mitsalgh/portalParkirTKI/Controller PCB/check in/preview/PCB Atas.png

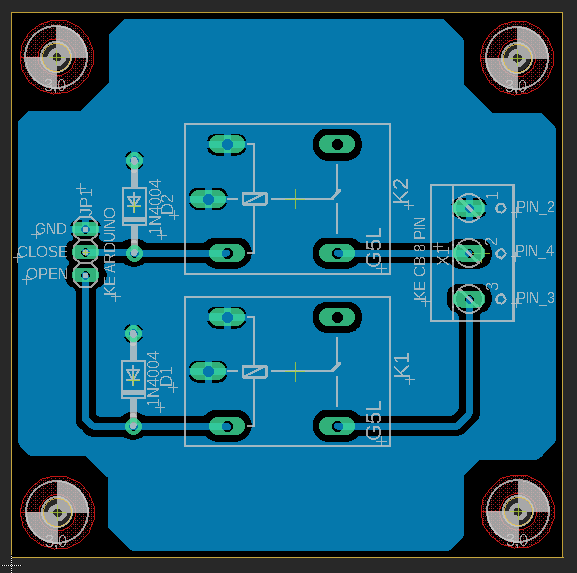
Controller PCB/check in/preview/PCB Atas.png
