mitsalgh/portalParkirTKI/Controller PCB/check in/preview/PCB Bawah.png

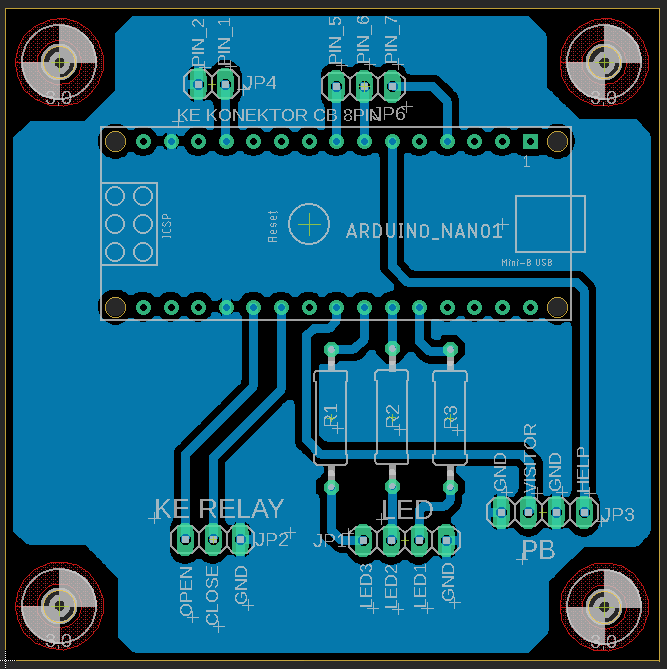
Controller PCB/check in/preview/PCB Bawah.png
