mitsalgh/portalParkirTKI/Controller PCB/check in/preview/Pemasangan PCB Atas dan Bawah.png

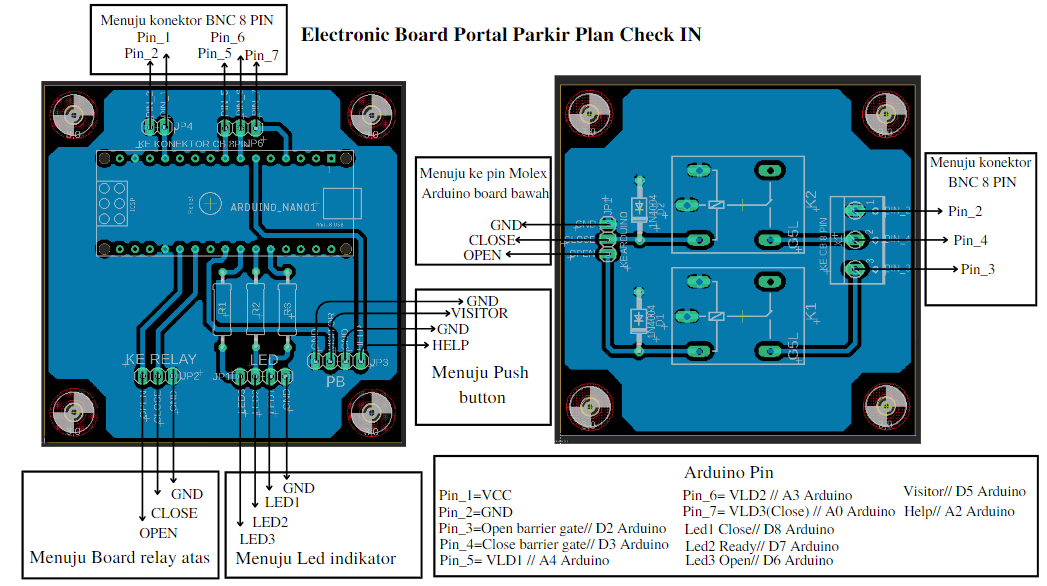
Controller PCB/check in/preview/Pemasangan PCB Atas dan Bawah.png
