mitsalgh/portalParkirTKI/Controller PCB/check in/preview/Skema Board Atas.png

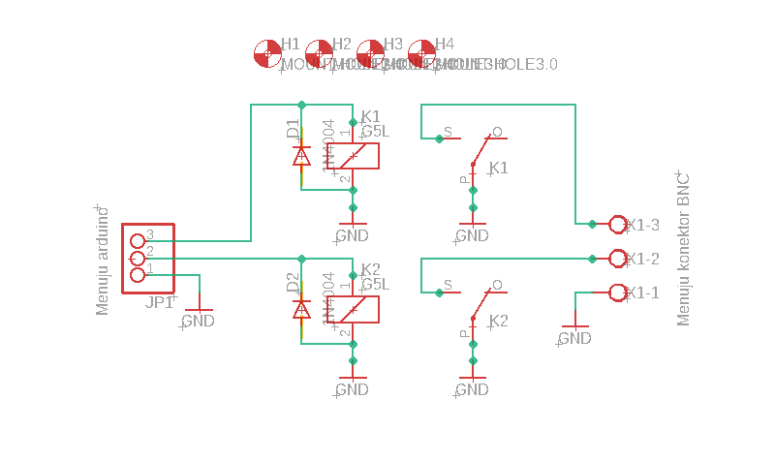
Controller PCB/check in/preview/Skema Board Atas.png
