mitsalgh/portalParkirTKI/Controller PCB/check in/preview/Skema Board Bawah.png

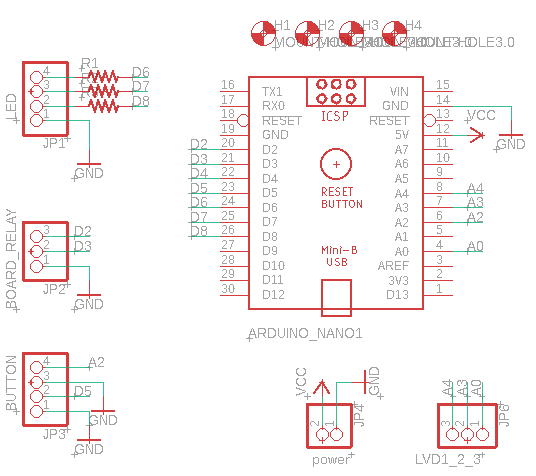
Controller PCB/check in/preview/Skema Board Bawah.png
