mitsalgh/portalParkirTKI/Controller PCB/check out/preview/PCB Bawah.png

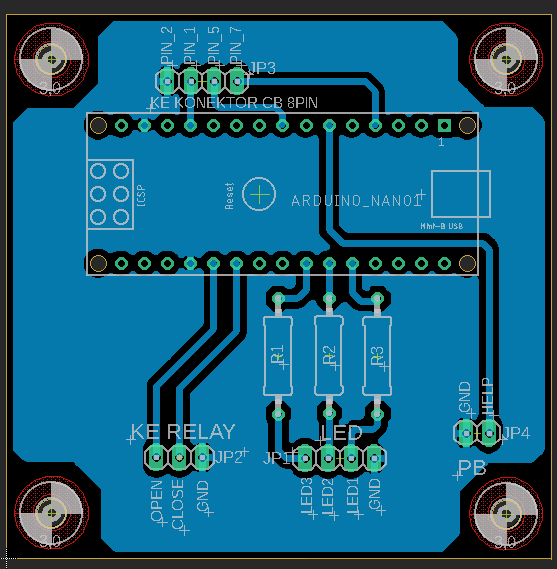
Controller PCB/check out/preview/PCB Bawah.png
