mitsalgh/portalParkirTKI/Controller PCB/check out/preview/Pemasangan PCB Atas dan Bawah.png

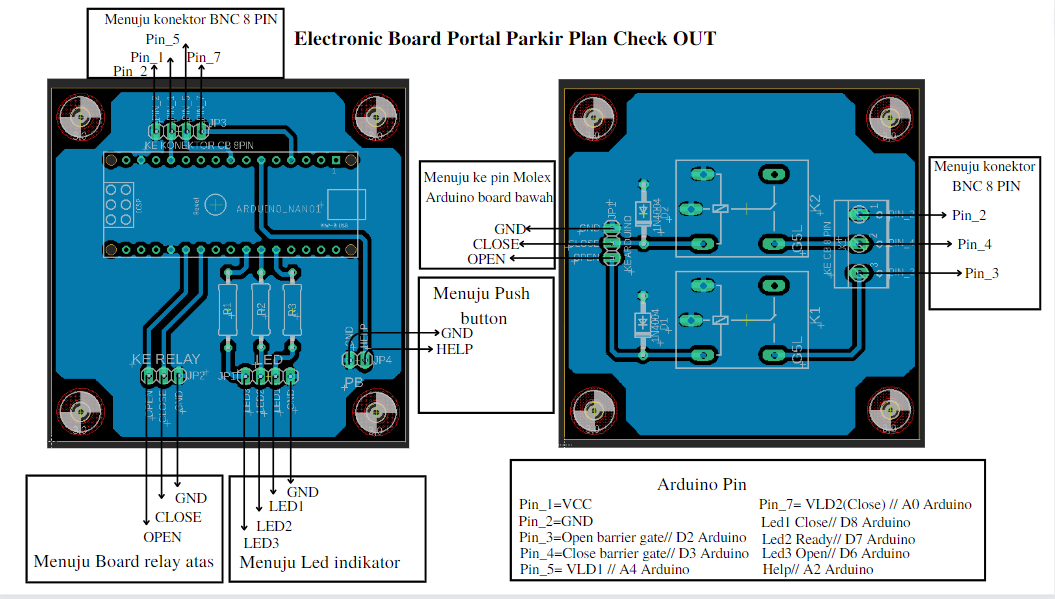
Controller PCB/check out/preview/Pemasangan PCB Atas dan Bawah.png
