mitsalgh/portalParkirTKI/Controller PCB/check out/preview/Skema Board Atas.png

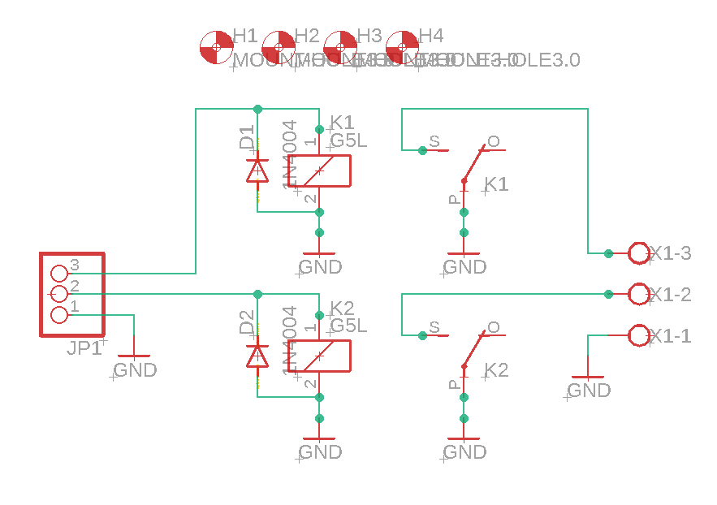
Controller PCB/check out/preview/Skema Board Atas.png
