mitsalgh/portalParkirTKI/Controller PCB/check out/preview/Skema Board Bawah.png

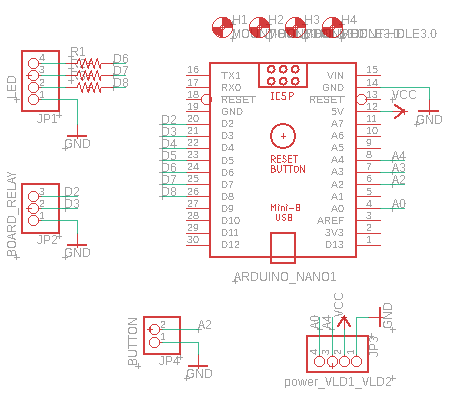
Controller PCB/check out/preview/Skema Board Bawah.png
