mitsalgh/portalParkirTKI/2D portal_parkir/Check IN/Acrylic/DFX/Acrylic E-Money.dxf

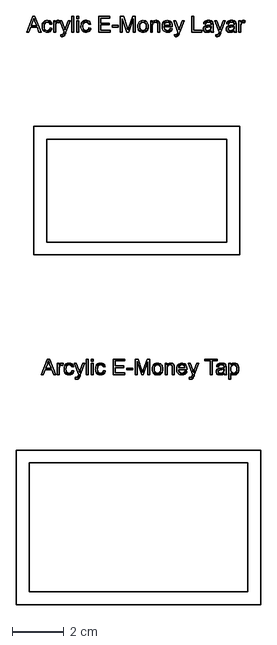
[picture p10: CAD file, 2023-12-26]
2D portal_parkir/Check IN/Acrylic/DFX/Acrylic E-Money.dxf
9.50 x 22.8 cm
