mitsalgh/portalParkirTKI/2D portal_parkir/Check IN/Plat/DFX/Box New Portal Parkir.dxf

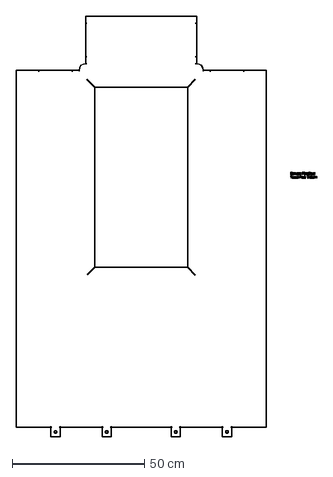
[picture p11: CAD file, 2023-12-26]
2D portal_parkir/Check IN/Plat/DFX/Box New Portal Parkir.dxf
113.7 x 158.8 cm
