mitsalgh/portalParkirTKI/2D portal_parkir/Check OUT/Acrylic/DFX/Acrylic NFC.dxf

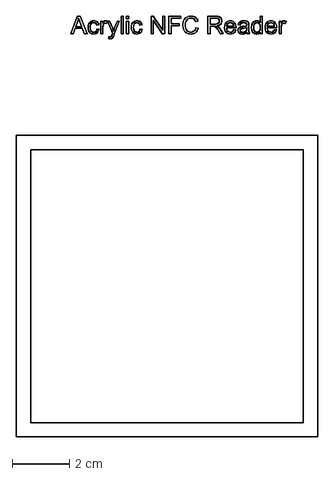
[picture p12: CAD file, 2023-12-26]
2D portal_parkir/Check OUT/Acrylic/DFX/Acrylic NFC.dxf
10.5 x 14.7 cm
