mitsalgh/portalParkirTKI/2D portal_parkir/Check OUT/Plat/DFX/Box Plat Belakang.dxf

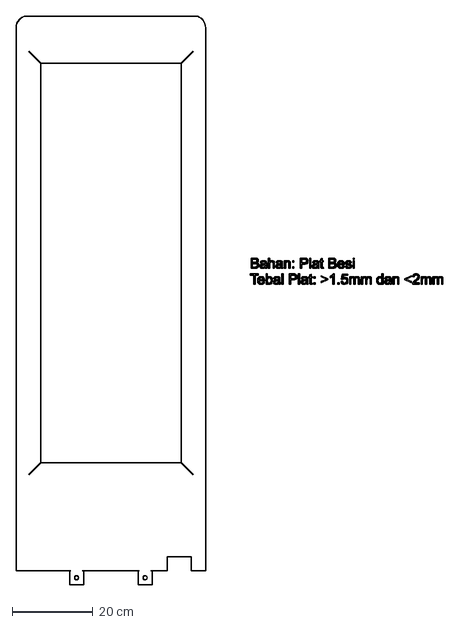
[picture p13: CAD file, 2023-12-26]
2D portal_parkir/Check OUT/Plat/DFX/Box Plat Belakang.dxf
105.9 x 141.0 cm
