mitsalgh/portalParkirTKI/2D portal_parkir/Check IN/Acrylic/DFX/Acrylic QR.dxf

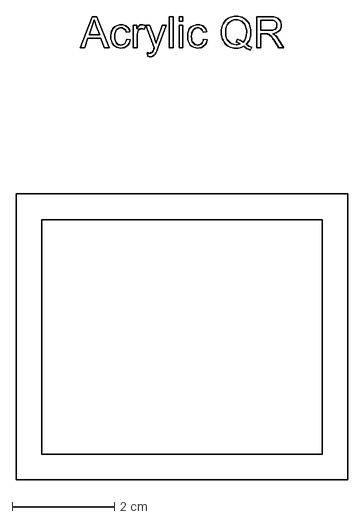
[picture p14: CAD file, 2023-12-26]
2D portal_parkir/Check IN/Acrylic/DFX/Acrylic QR.dxf
6.50 x 9.08 cm
