mitsalgh/portalParkirTKI/2D portal_parkir/Check IN/Plat/DFX/Bracket Printer.dxf

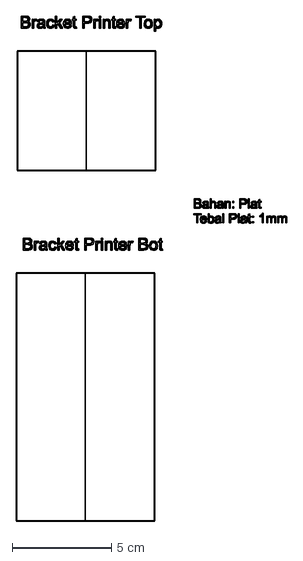
[picture p15: CAD file, 2023-12-26]
2D portal_parkir/Check IN/Plat/DFX/Bracket Printer.dxf
13.6 x 25.5 cm
