mitsalgh/portalParkirTKI/2D portal_parkir/Check OUT/Plat/DFX/Bracket NFC.dxf

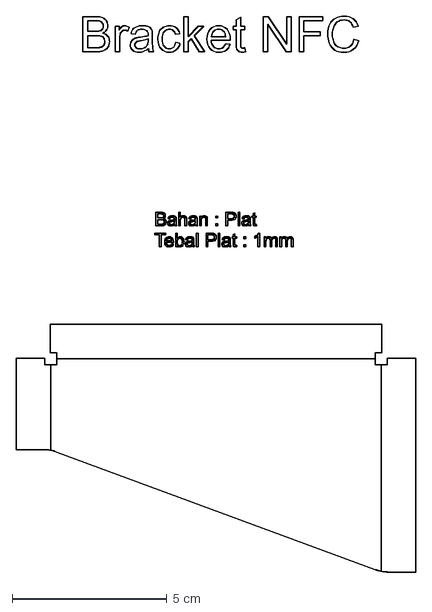
[picture p16: CAD file, 2023-12-26]
2D portal_parkir/Check OUT/Plat/DFX/Bracket NFC.dxf
12.9 x 18.0 cm
