mitsalgh/portalParkirTKI/2D portal_parkir/Check IN/Plat/DFX/Desain 2D Pintu Belakang.dxf

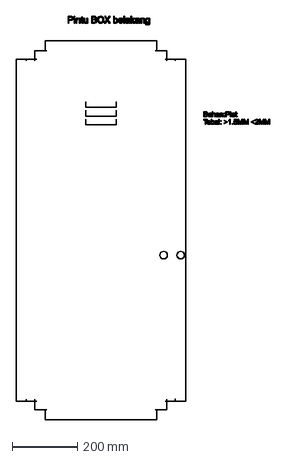
[picture p17: CAD file, 2023-12-26]
2D portal_parkir/Check IN/Plat/DFX/Desain 2D Pintu Belakang.dxf
776.1 x 1235.5 mm
