mitsalgh/portalParkirTKI/2D portal_parkir/Check OUT/Acrylic/DFX/Acrylic Monitor.dxf

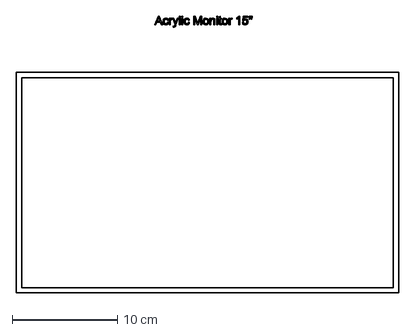
[picture p18: CAD file, 2023-12-26]
2D portal_parkir/Check OUT/Acrylic/DFX/Acrylic Monitor.dxf
36.4 x 26.4 cm
