mitsalgh/portalParkirTKI/2D portal_parkir/Check OUT/Plat/DFX/Desain 2D Pintu Check Out.dxf

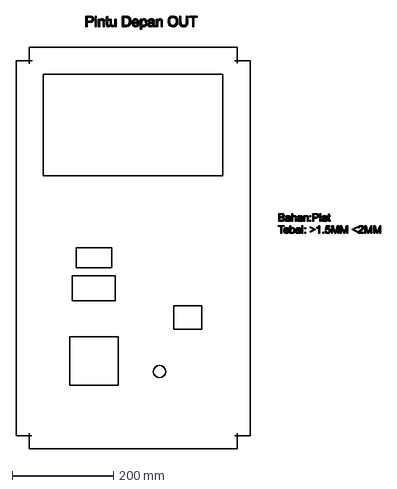
[picture p19: CAD file, 2023-12-26]
2D portal_parkir/Check OUT/Plat/DFX/Desain 2D Pintu Check Out.dxf
719.6 x 853.8 mm
