mitsalgh/portalParkirTKI/2D portal_parkir/Check IN/Plat/DFX/Bracket MCB.dxf

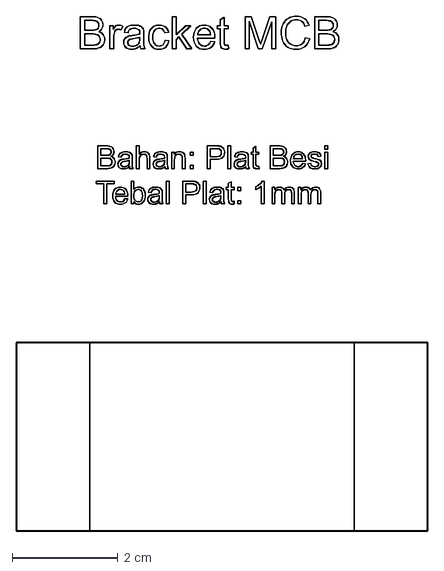
[picture p20: CAD file, 2023-12-26]
2D portal_parkir/Check IN/Plat/DFX/Bracket MCB.dxf
7.77 x 9.71 cm
