mitsalgh/portalParkirTKI/2D portal_parkir/Check IN/Plat/DFX/Bracket QR.dxf

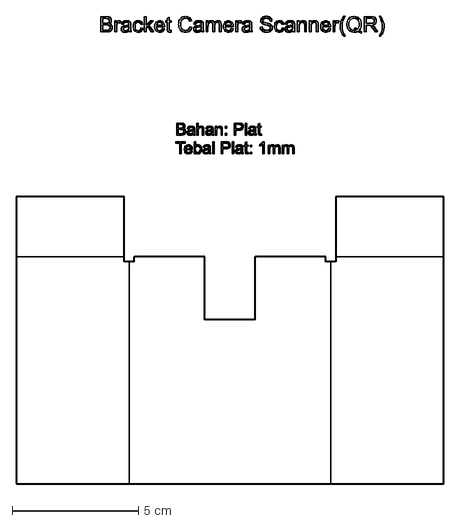
[picture p21: CAD file, 2023-12-26]
2D portal_parkir/Check IN/Plat/DFX/Bracket QR.dxf
17.0 x 18.5 cm
