mitsalgh/portalParkirTKI/2D portal_parkir/Check IN/Plat/DFX/Bracket E-Money.dxf

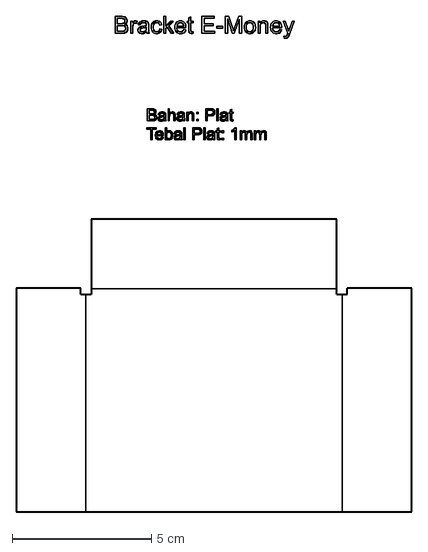
[picture p22: CAD file, 2023-12-26]
2D portal_parkir/Check IN/Plat/DFX/Bracket E-Money.dxf
14.2 x 17.8 cm
