mitsalgh/portalParkirTKI/2D portal_parkir/Check IN/Plat/DFX/Bracket STB.dxf

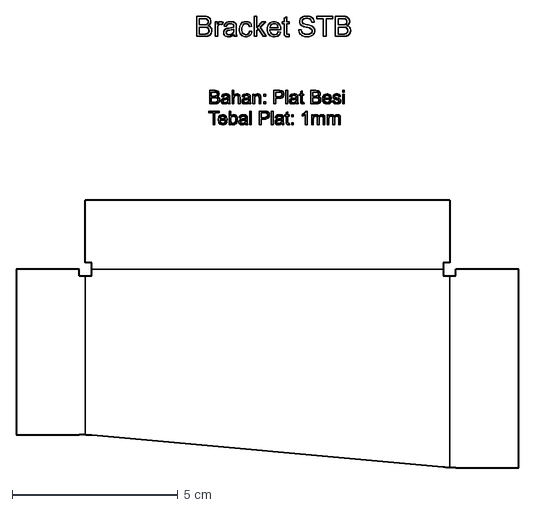
[picture p23: CAD file, 2023-12-26]
2D portal_parkir/Check IN/Plat/DFX/Bracket STB.dxf
15.2 x 13.6 cm
