mitsalgh/portalParkirTKI/2D portal_parkir/Check IN/Plat/DFX/Desain 2D Pintu Check In.dxf

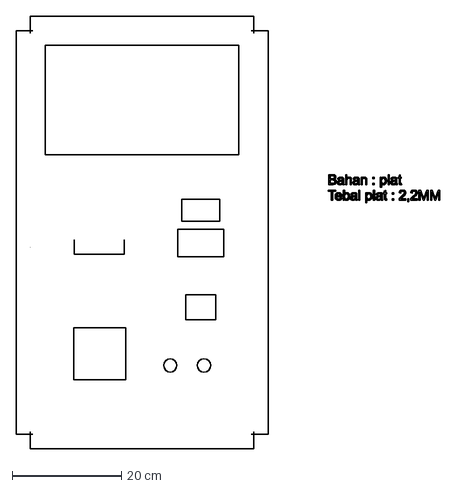
[picture p24: CAD file, 2023-12-26]
2D portal_parkir/Check IN/Plat/DFX/Desain 2D Pintu Check In.dxf
77.7 x 79.2 cm
