mitsalgh/portalParkirTKI/Controller PCB/check in/Board_Skematic/board Bawah/portal parkir bawah.brd

## EAGLE design Controller PCB/check in/Board_Skematic/board Bawah/portal parkir bawah.brd (2023-11-13)

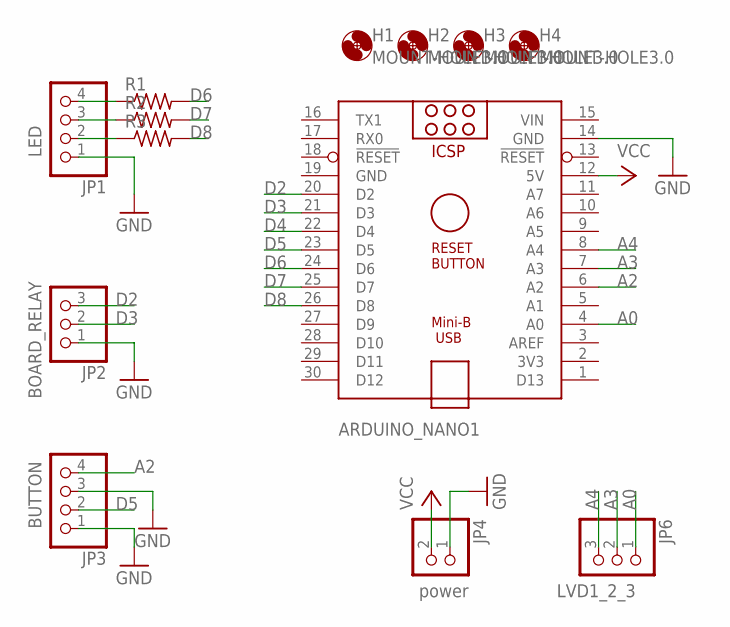
[picture p25: schematic portal parkir bawah.sch]

Parts:
ARDUINO_NANO1: ARDUINO_NANO
H1, H2, H3, H4: MOUNT-HOLE3.0; 3,0
JP1, JP3: PINHD-1X4; 1X04
JP2, JP6: PINHD-1X3; 1X03
JP4: PINHD-1X2; 1X02
R1, R2, R3: R-US_0309/12; 0309/12

Connections:
A0: ARDUINO_NANO1.4 (A0), JP6.1
A2: ARDUINO_NANO1.6 (A2), JP3.4
A3: ARDUINO_NANO1.7 (A3), JP6.2
A4: ARDUINO_NANO1.8 (A4), JP6.3
D2: ARDUINO_NANO1.20 (D2), JP2.3
D3: ARDUINO_NANO1.21 (D3), JP2.2
D4: ARDUINO_NANO1.22 (D4)
D5: ARDUINO_NANO1.23 (D5), JP3.2
D6: ARDUINO_NANO1.24 (D6), R1.2
D7: ARDUINO_NANO1.25 (D7), R2.2
D8: ARDUINO_NANO1.26 (D8), R3.2
GND: ARDUINO_NANO1.14 (GND), ARDUINO_NANO1.19 (GND), JP1.1, JP2.1, JP3.1, JP3.3, JP4.1
unnamed: JP1.2, R3.1
unnamed: JP1.3, R2.1
unnamed: JP1.4, R1.1
VCC: ARDUINO_NANO1.12 (5V), JP4.2
VIN: ARDUINO_NANO1.15 (VIN)

Notes on the sheet:
power
LVD1_2_3
BUTTON
BOARD_RELAY
LED

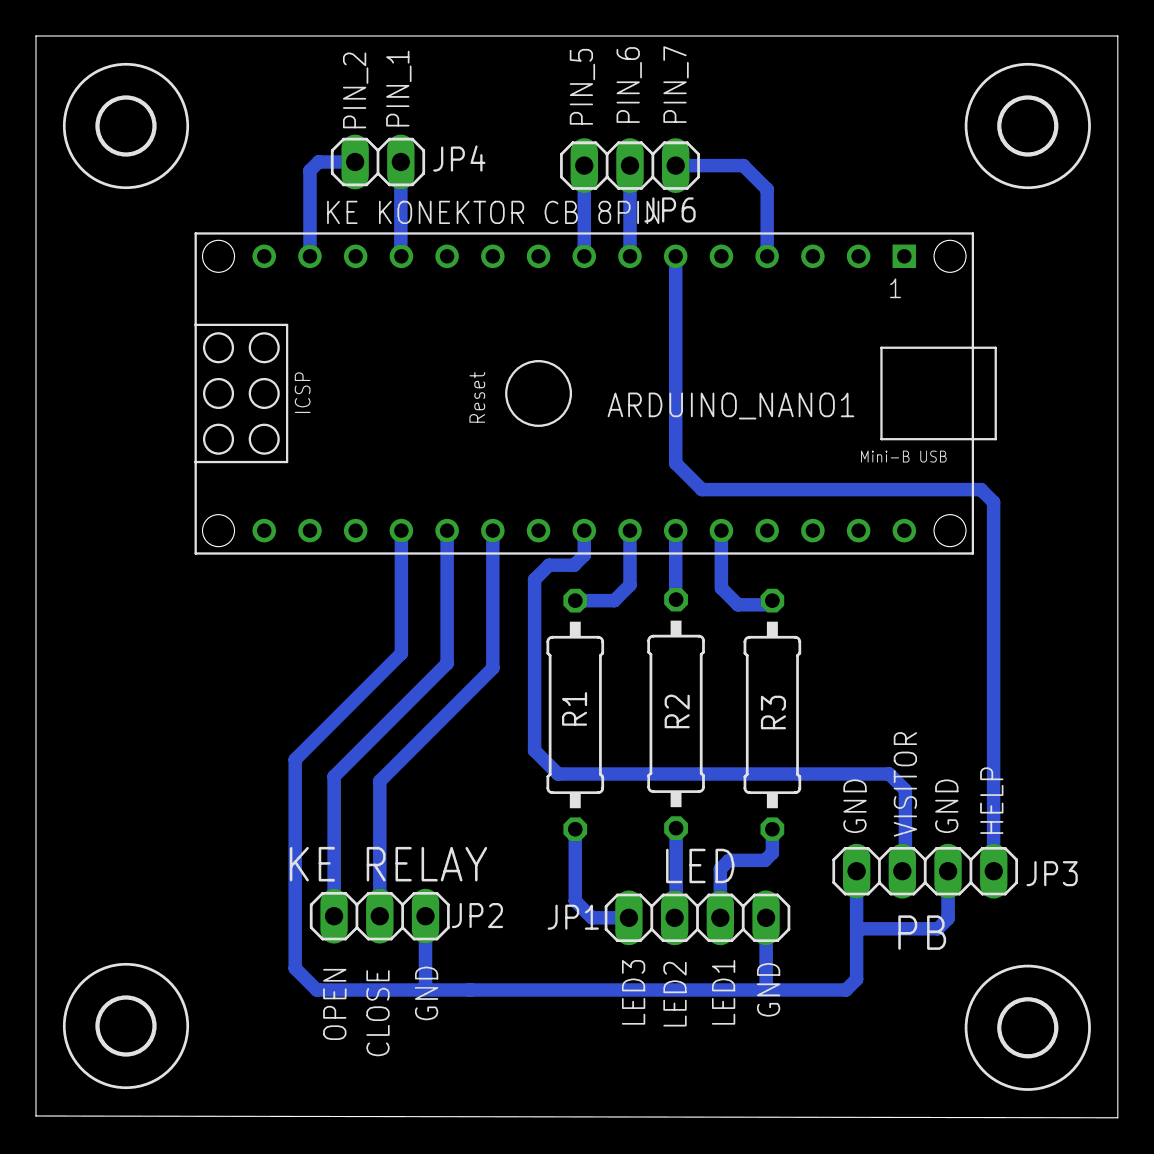
[picture p26: board portal parkir bawah.brd from above]

Board: 2 copper layers, 60.1 x 60.1 mm, 13 parts (0 on the bottom side), 15 nets.
