mitsalgh/portalParkirTKI/Controller PCB/check in/Board_Skematic/board Atas/portal parkir.brd

## EAGLE design Controller PCB/check in/Board_Skematic/board Atas/portal parkir.brd (2023-11-09)

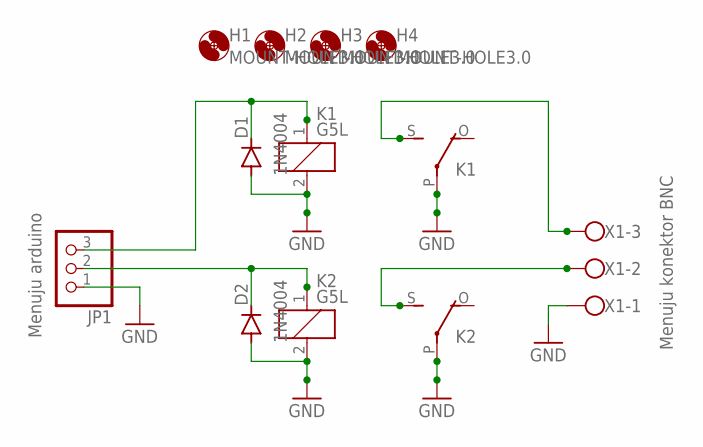
[picture p27: schematic portal parkir.sch]

Parts:
D1, D2: 1N4004; DO41-10
H1, H2, H3, H4: MOUNT-HOLE3.0; 3,0
JP1: PINHD-1X3; 1X03
K1, K2: G5L; G5LE
X1: W237-103

Connections:
GND: D1.A, D2.A, JP1.1, K1.2, K1.P, K2.2, K2.P, X1.1
unnamed: D1.C, JP1.3, K1.1
unnamed: D2.C, JP1.2, K2.1
unnamed: K2.S, X1.2
unnamed: K1.S, X1.3

Notes on the sheet:
Menuju arduino
Menuju konektor BNC

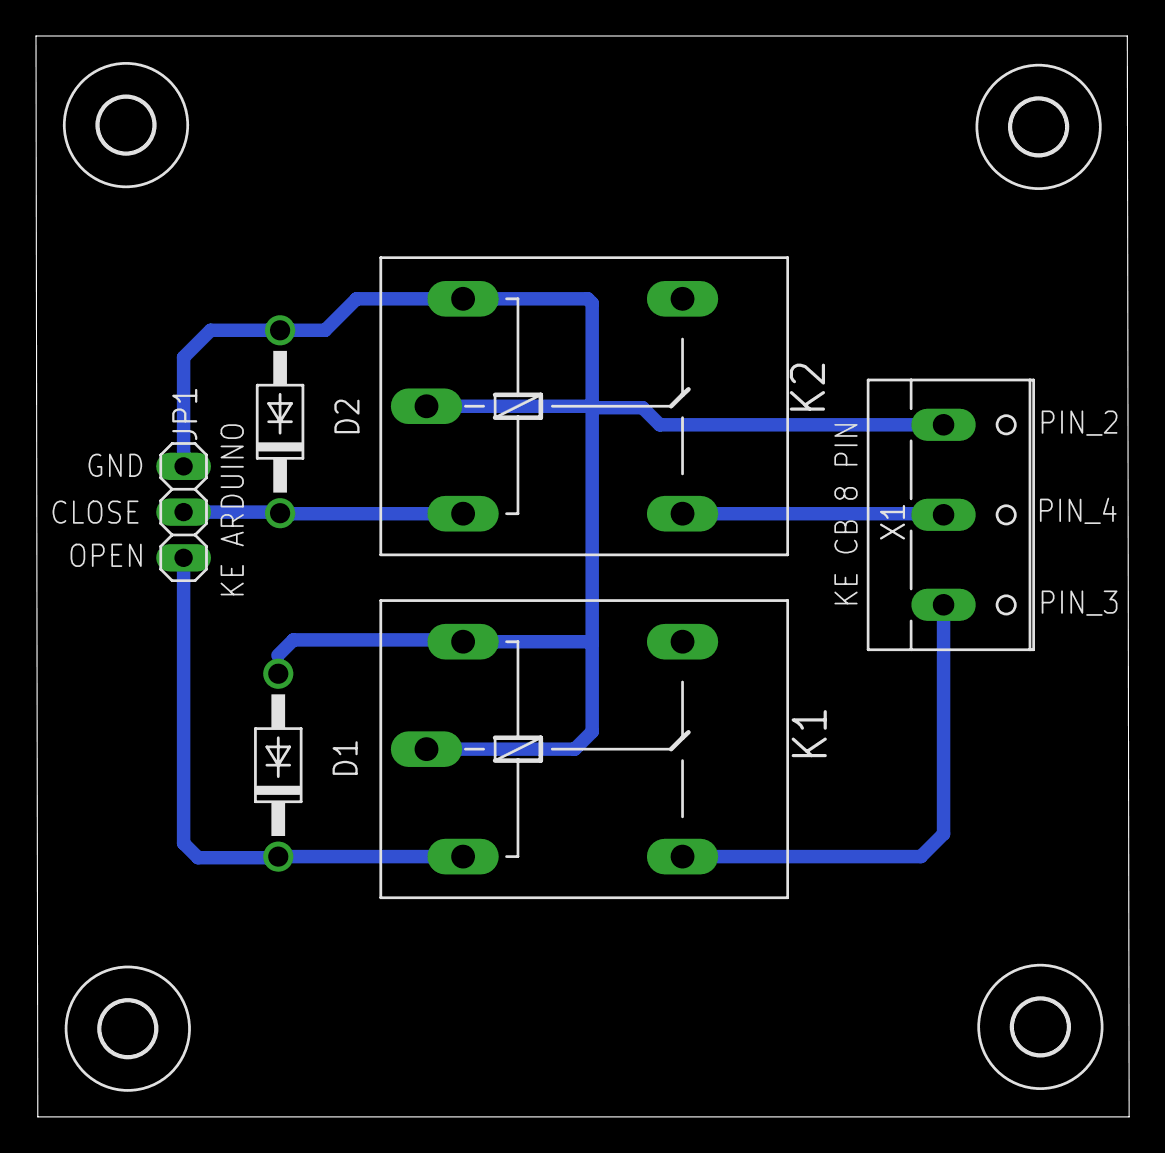
[picture p28: board portal parkir.brd from above]

Board: 2 copper layers, 60.7 x 60.1 mm, 10 parts (0 on the bottom side), 5 nets.
