mitsalgh/portalParkirTKI/wiring Box/Wiring Box New/Check IN/Flow Management System IN.png

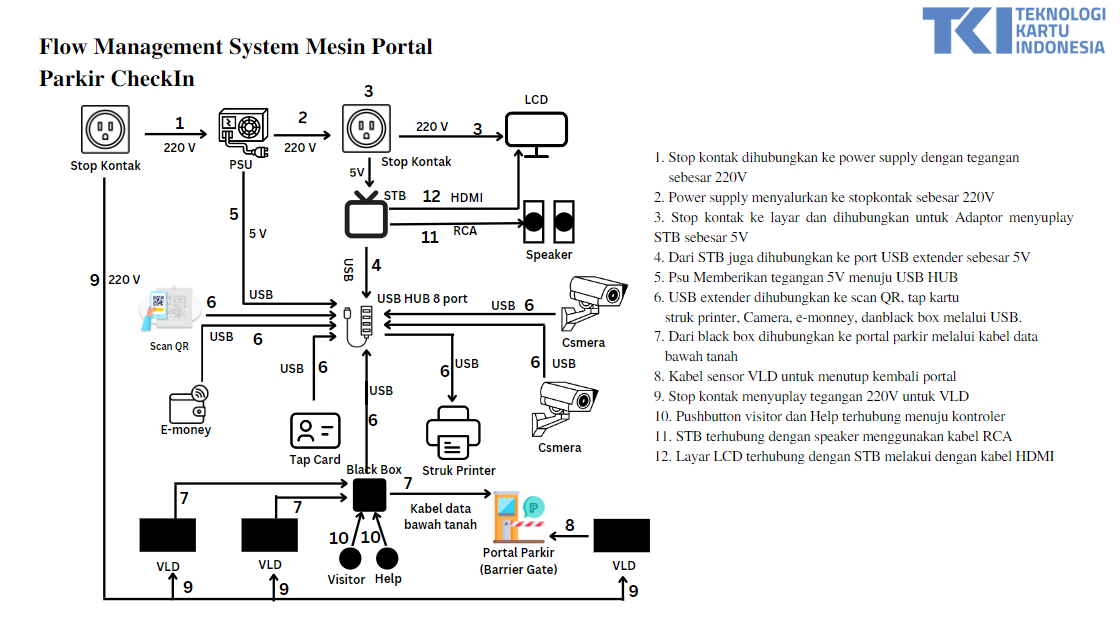
wiring Box/Wiring Box New/Check IN/Flow Management System IN.png
