mitsalgh/portalParkirTKI/wiring Box/Wiring Box New/Check IN/Wiring BOX IN.png

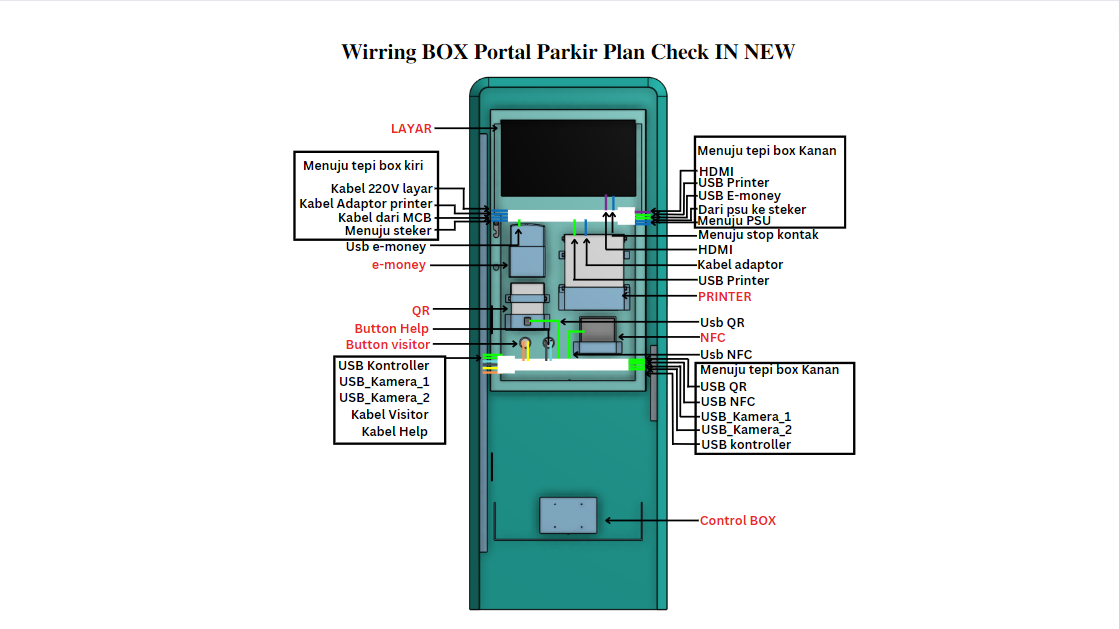
wiring Box/Wiring Box New/Check IN/Wiring BOX IN.png
