mitsalgh/portalParkirTKI/wiring Box/Wiring Box New/Check IN/Wiring BOX IN_kanan.png

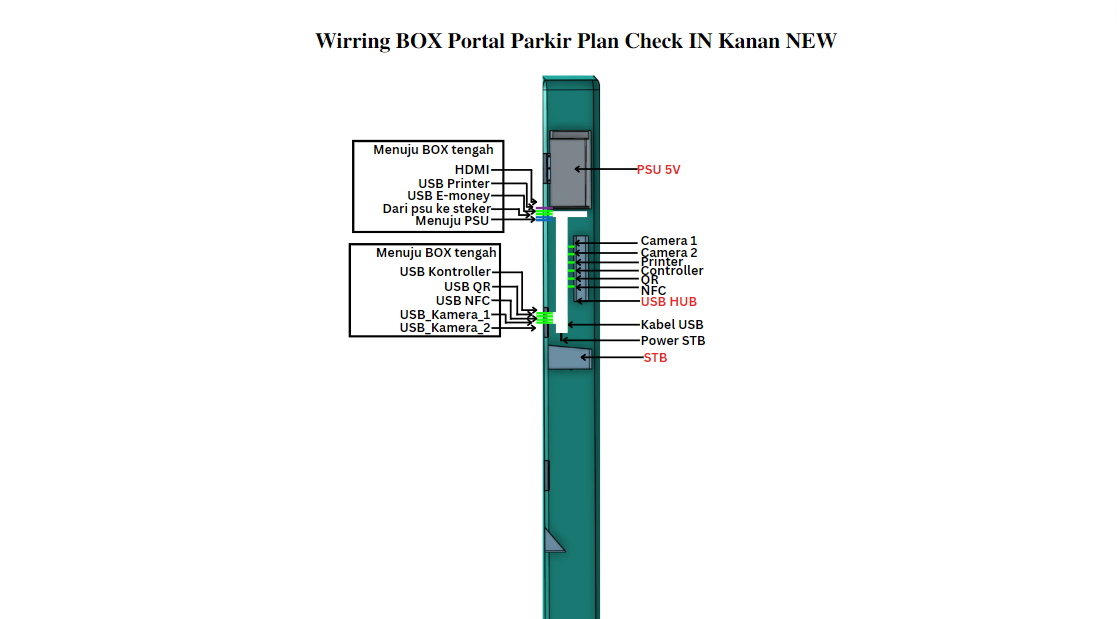
wiring Box/Wiring Box New/Check IN/Wiring BOX IN_kanan.png
