mitsalgh/portalParkirTKI/wiring Box/Wiring Box New/Check IN/Wiring BOX IN_kiri.png

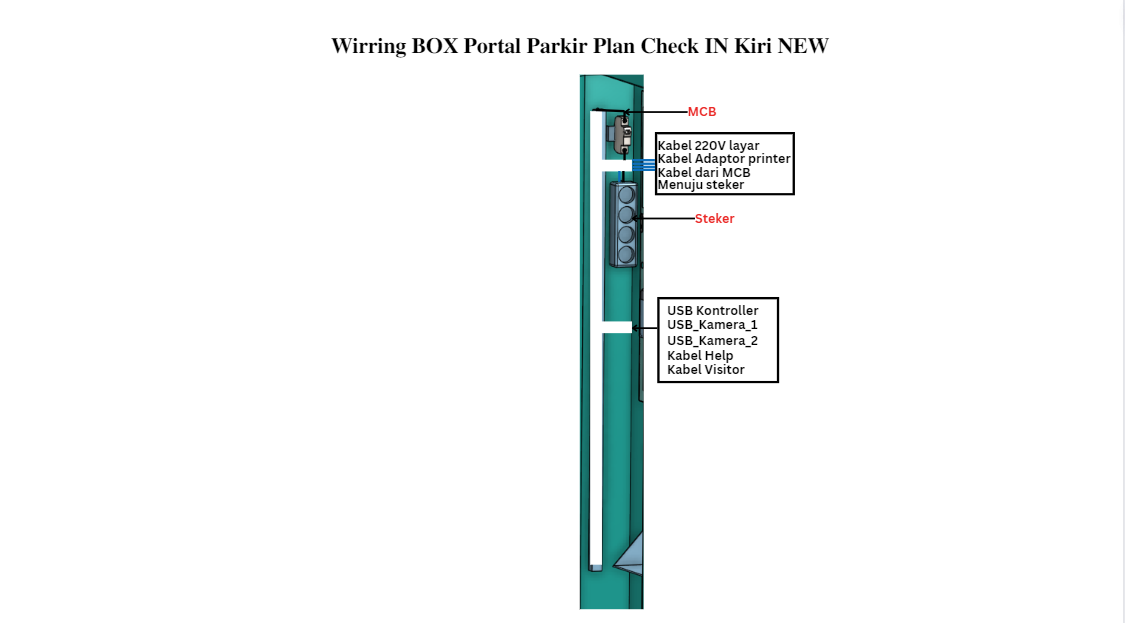
wiring Box/Wiring Box New/Check IN/Wiring BOX IN_kiri.png
