mitsalgh/portalParkirTKI/wiring Box/Wiring Box New/Check Out/Flow Management System OUT.png

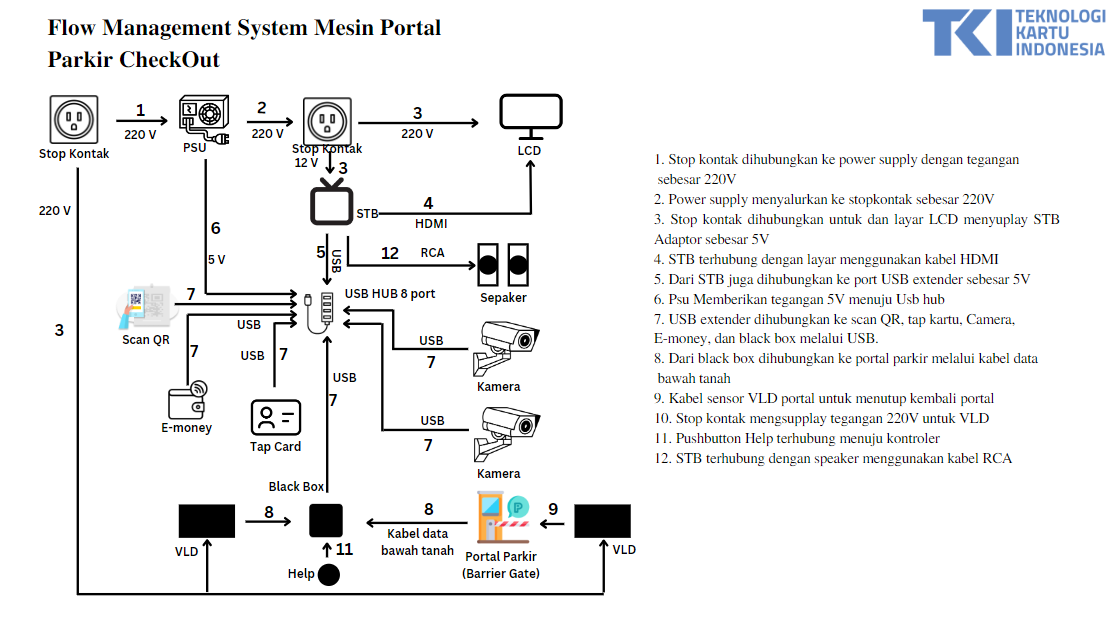
wiring Box/Wiring Box New/Check Out/Flow Management System OUT.png
